kaf3/dimmer/altium projects/Smart Dimmer/Project Outputs for Smart Dimmer/print.PDF

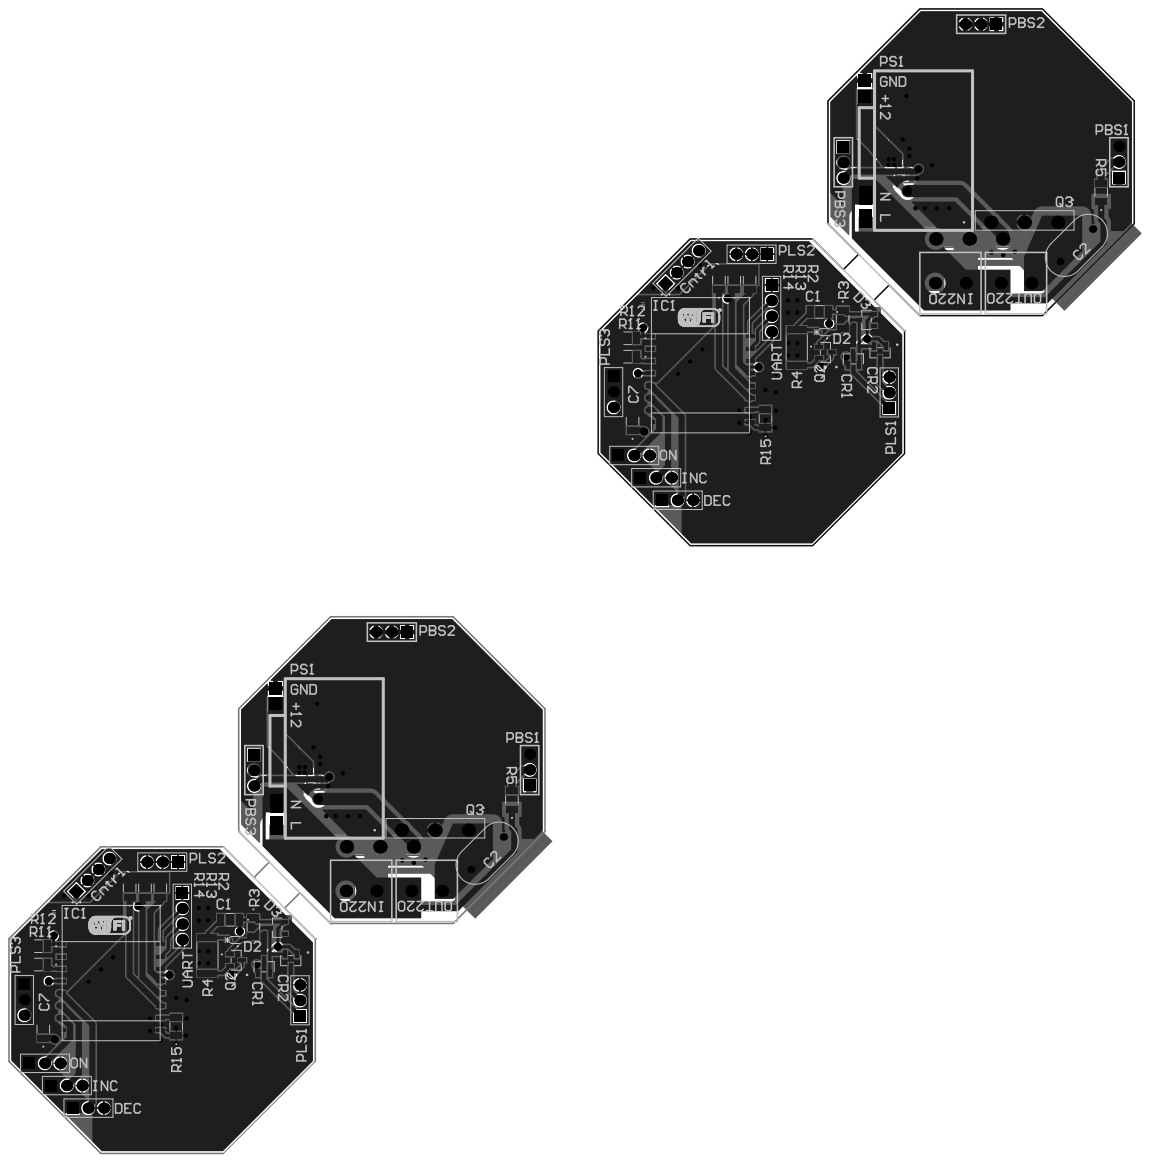
[picture p59: page 1]
