kaf3/dimmer/altium projects/Smart Dimmer/dimmer.pdf

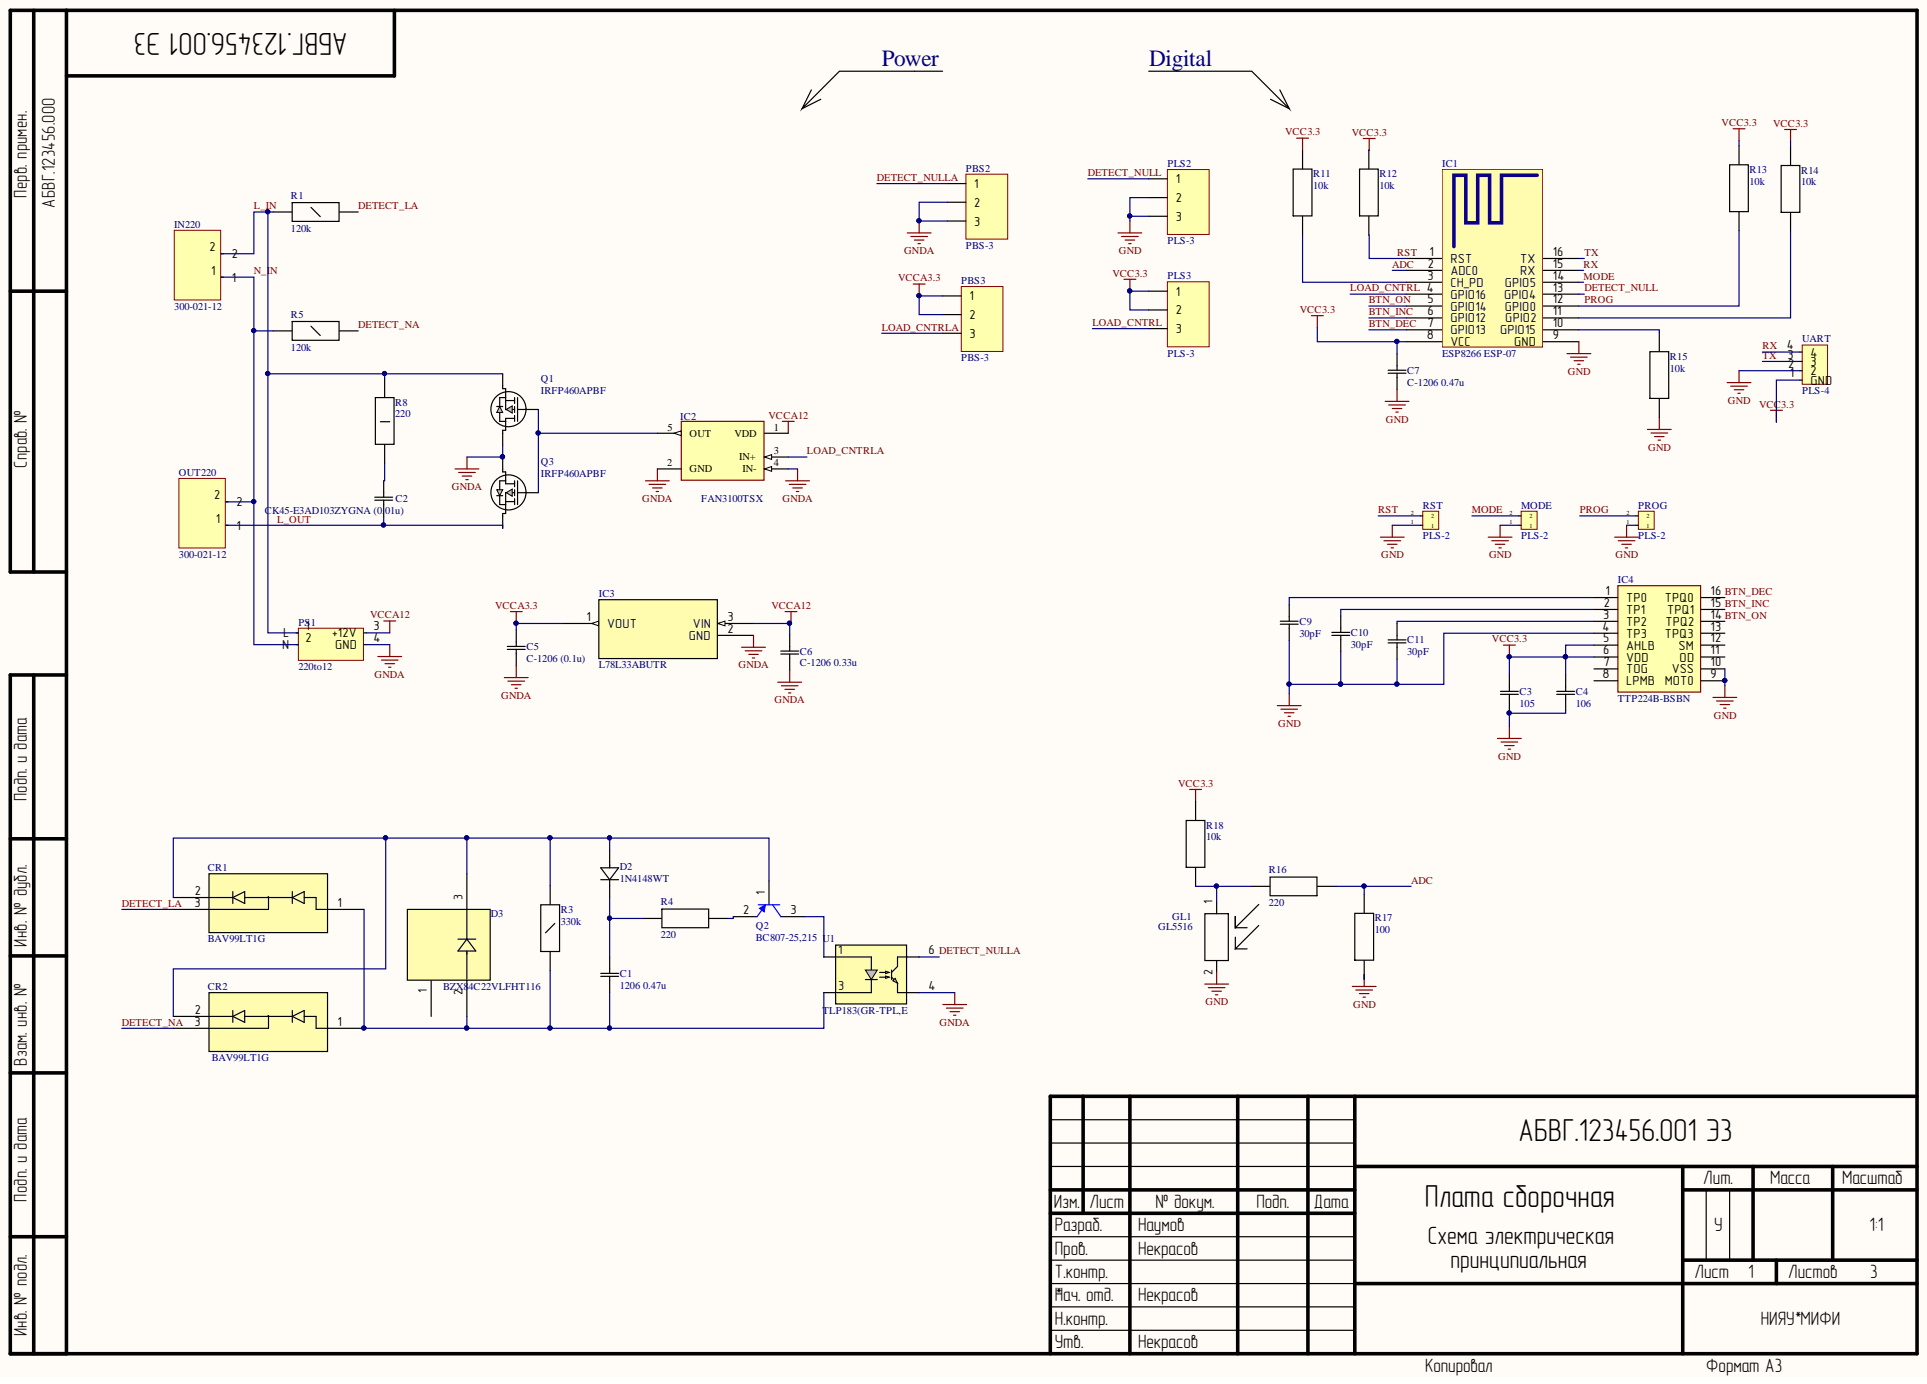
[picture p61: page 1]

Инв. № подл. Инв. № дубл. Подп. и дата Взам. инв. № Подп. и дата Перв. примен. Справ. №

АБВГ.123456.001 Э3

Плата сборочная принципиальная | Лит. | Масса | Масштаб

Изм. | Лист | № докум. | Подп. | Дата | | | У | | 1:1 Схема электрическая
Разраб. | | Наумов
Пров. | | Некрасов
Т.контр. | | | | | Лист 1 | Листов 3
* Нач. отд. | Некрасов | | | | НИЯУ МИФИ *
Н.контр.
Утв. | Некрасов
