kaf3/dimmer/altium projects/Smart Dimmer/drafts/PCB12_sensor.PDF

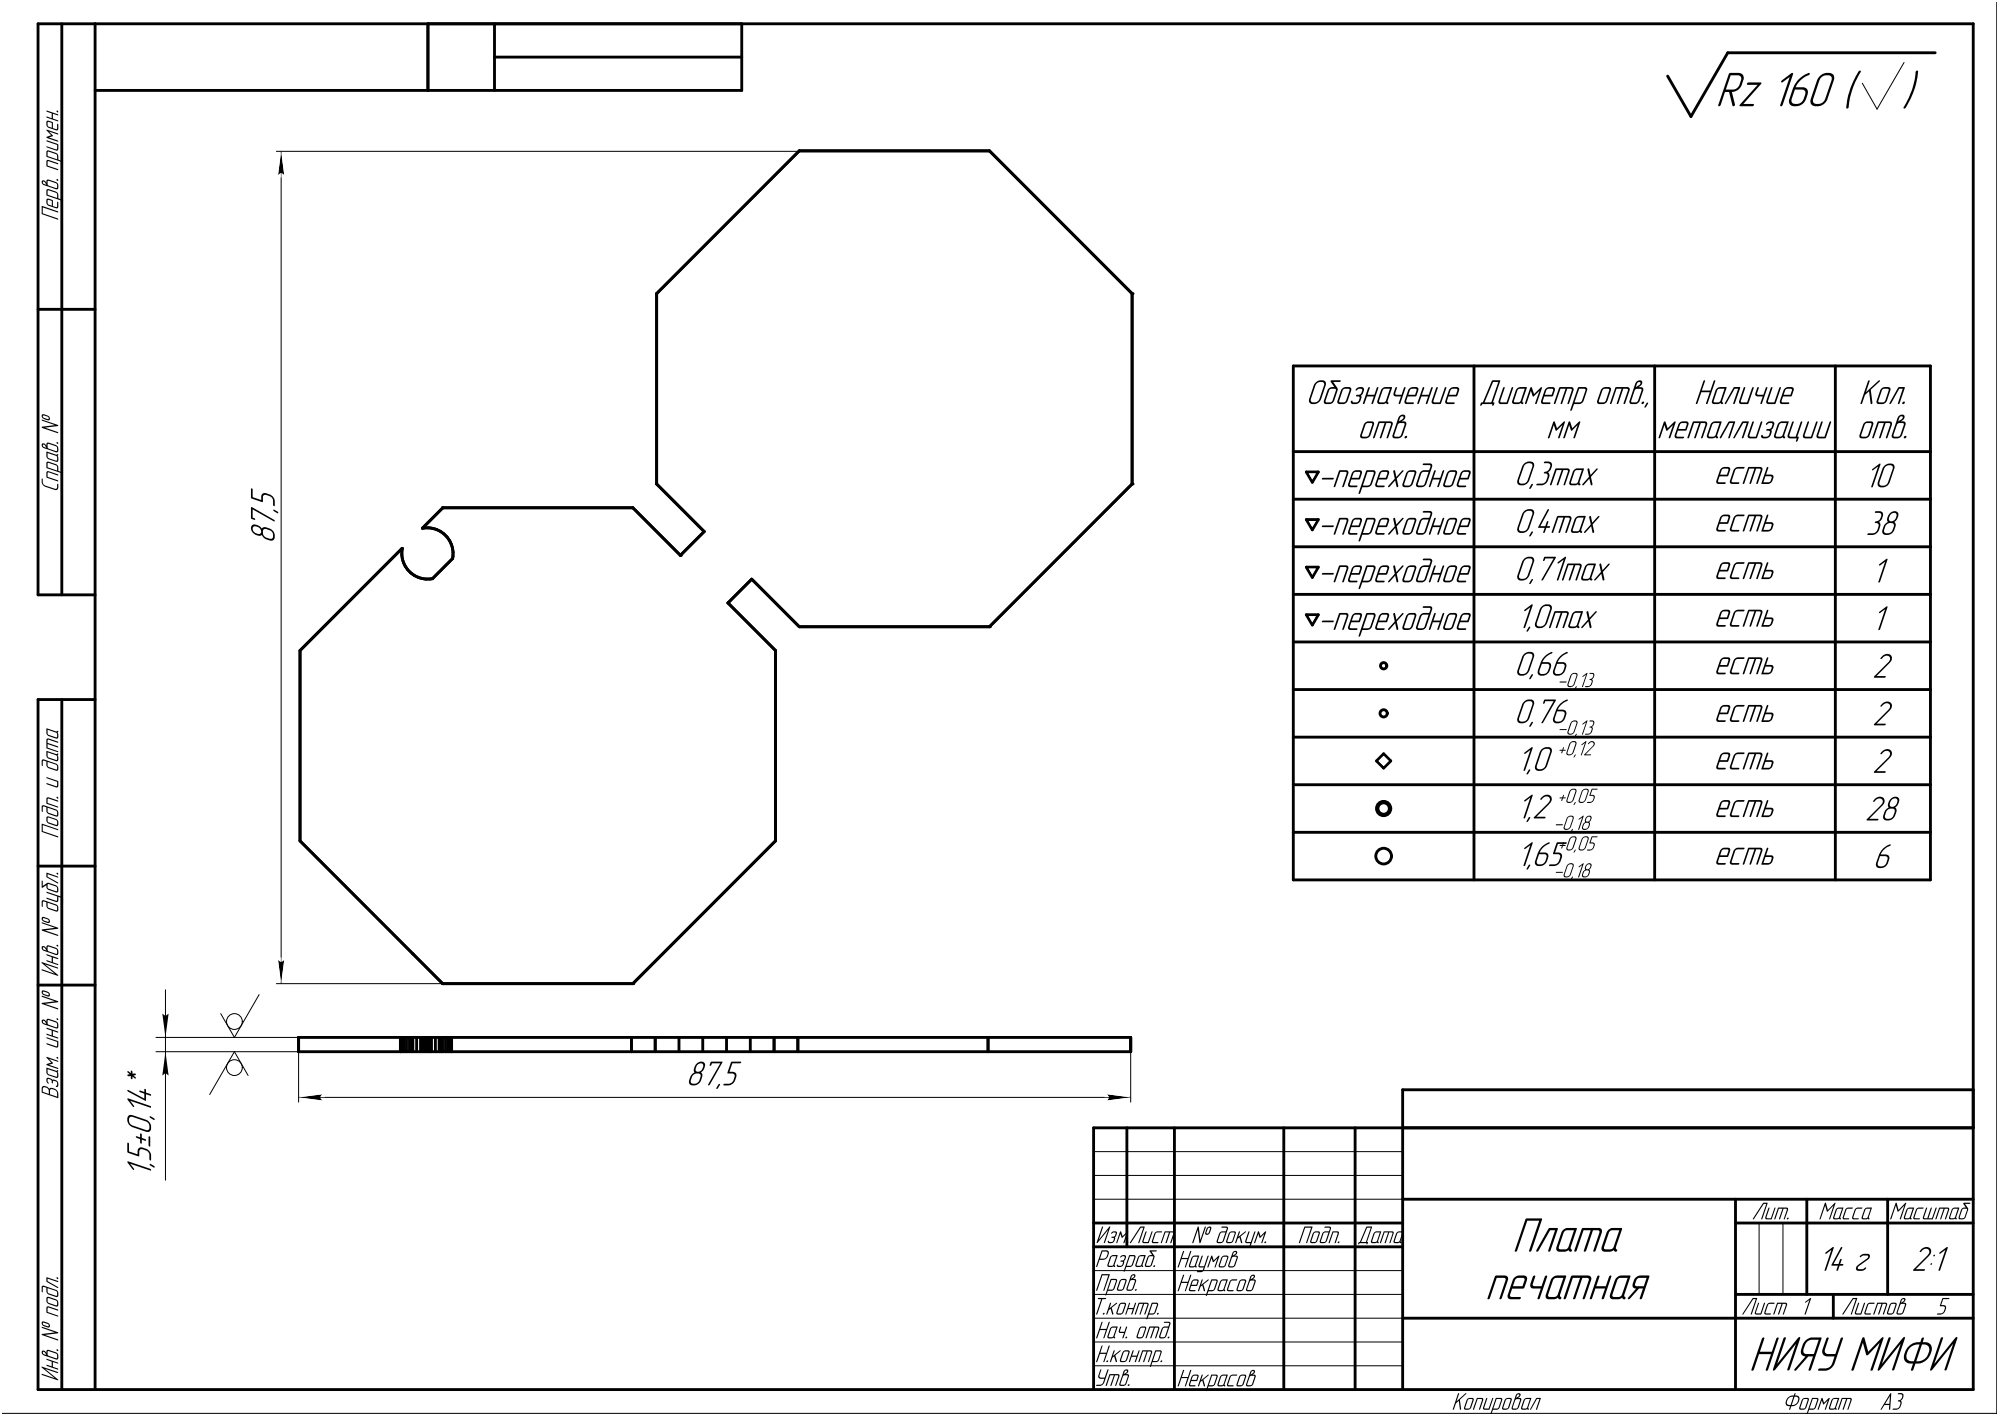
[picture p63: page 1]

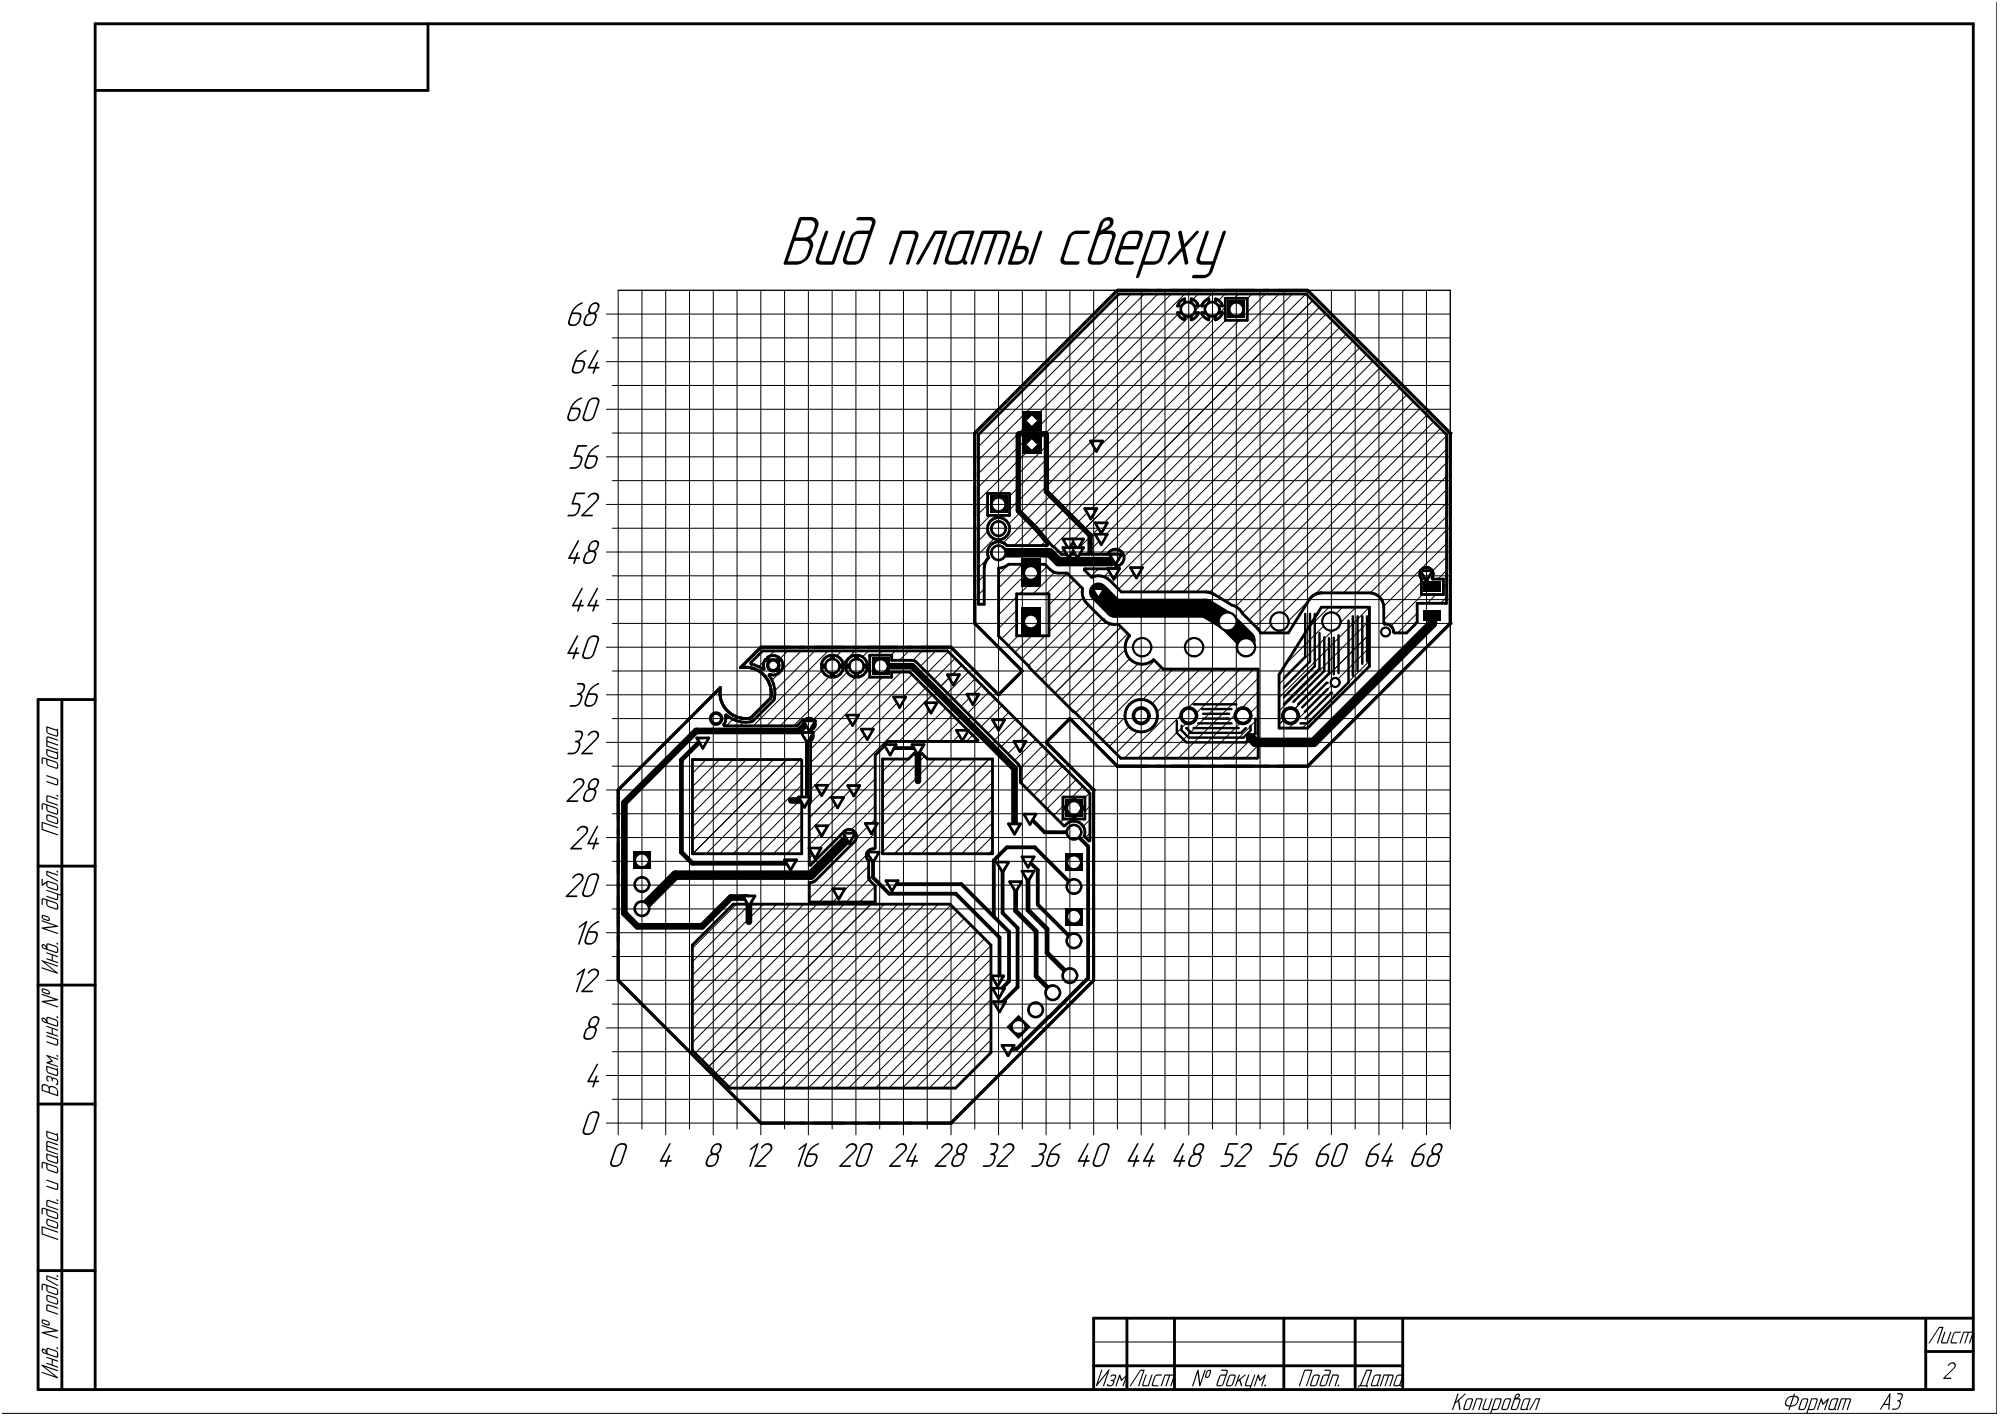
[picture p64: page 2]

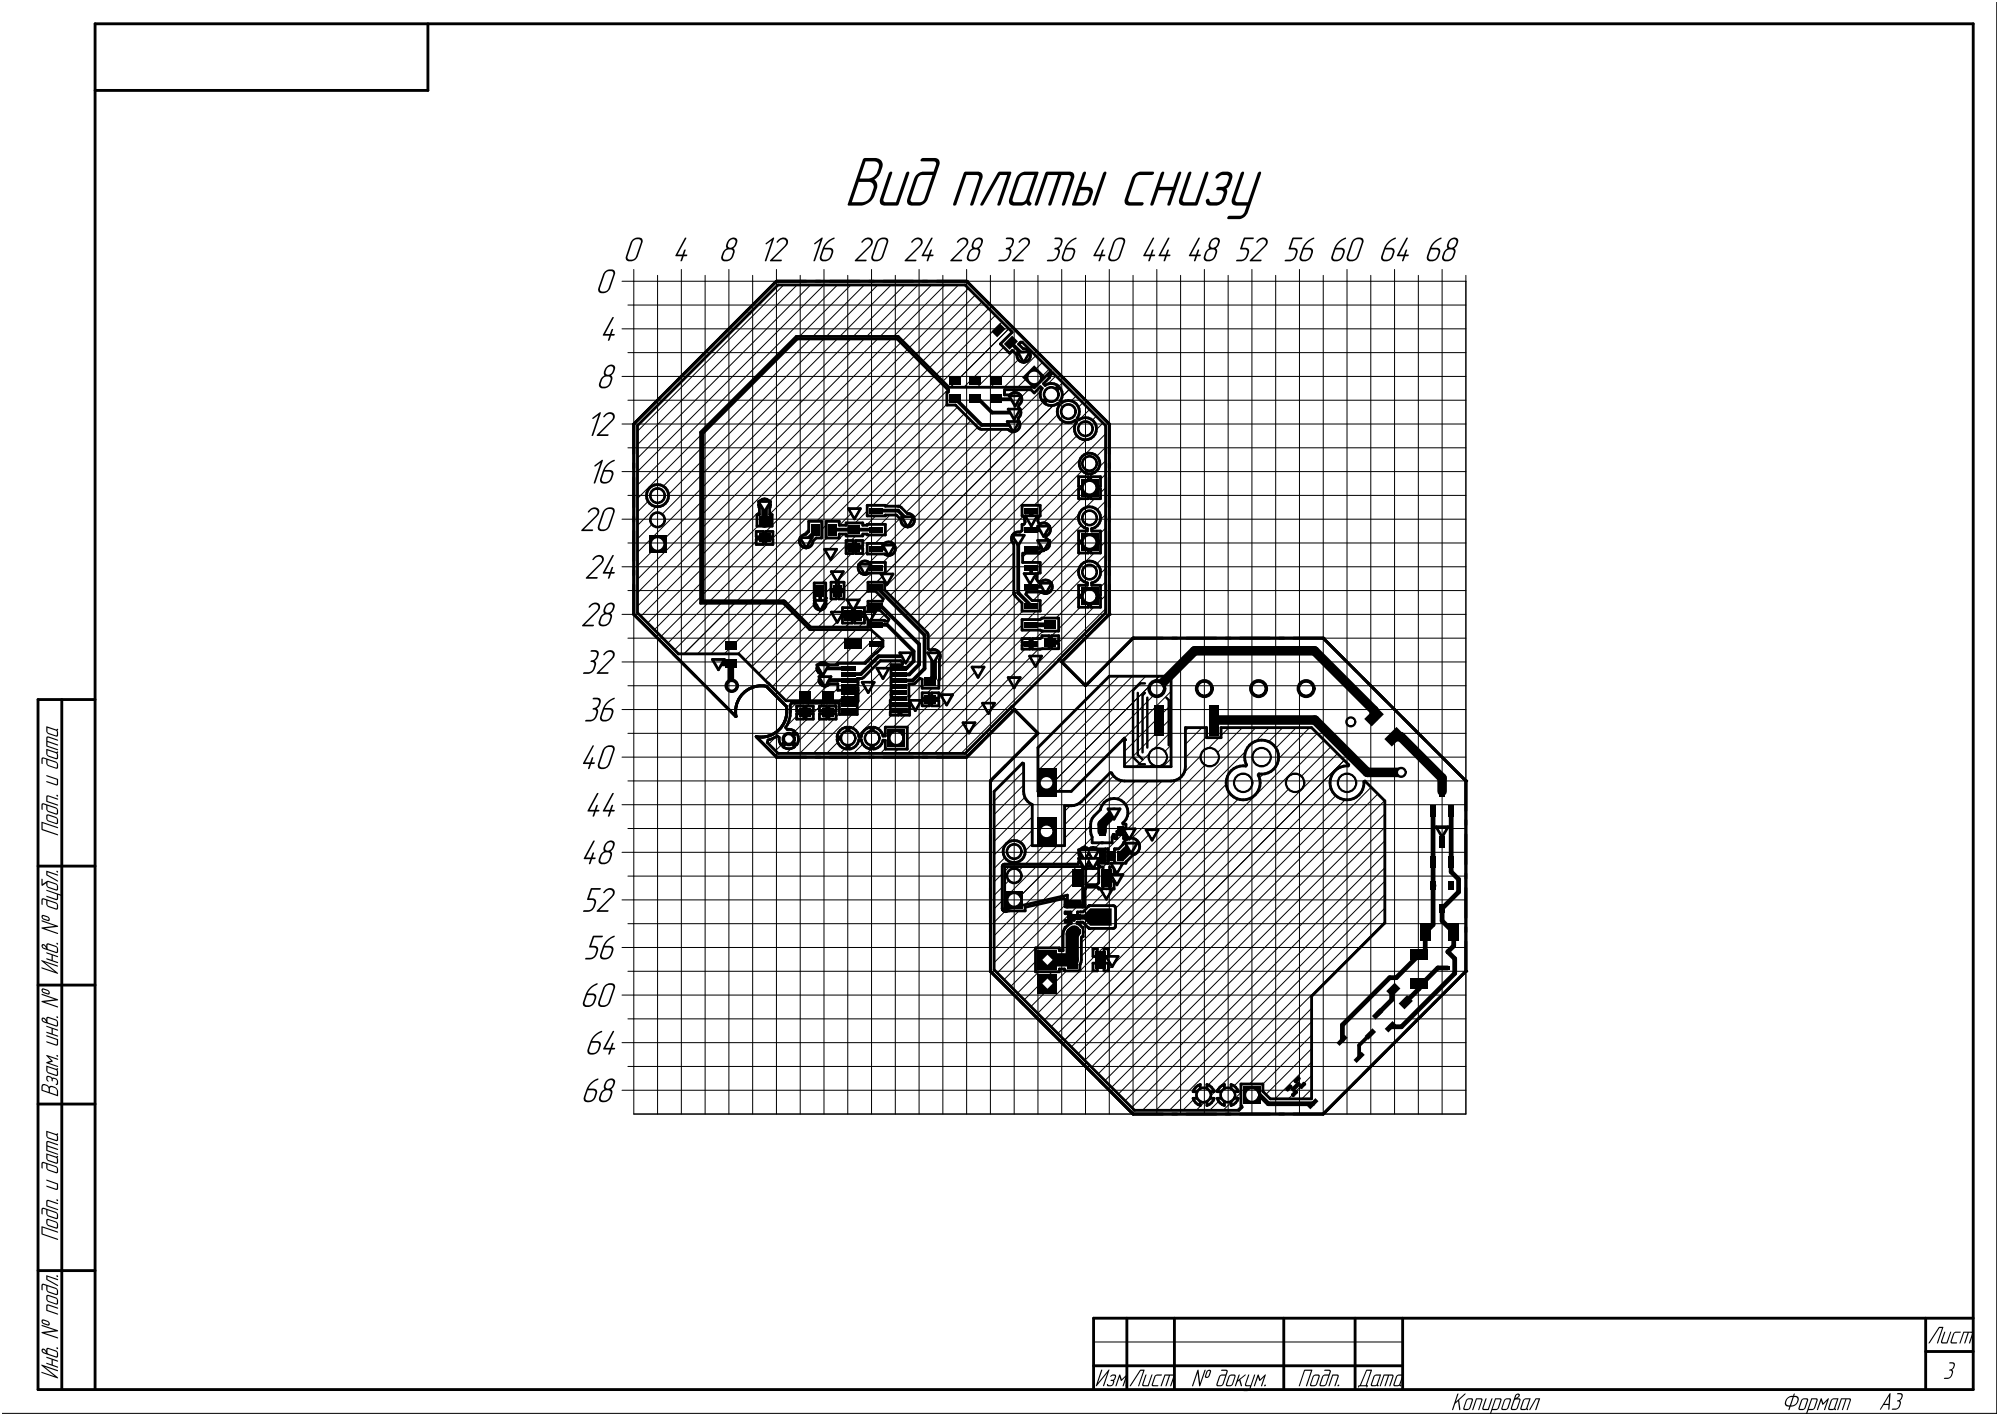
[picture p65: page 3]

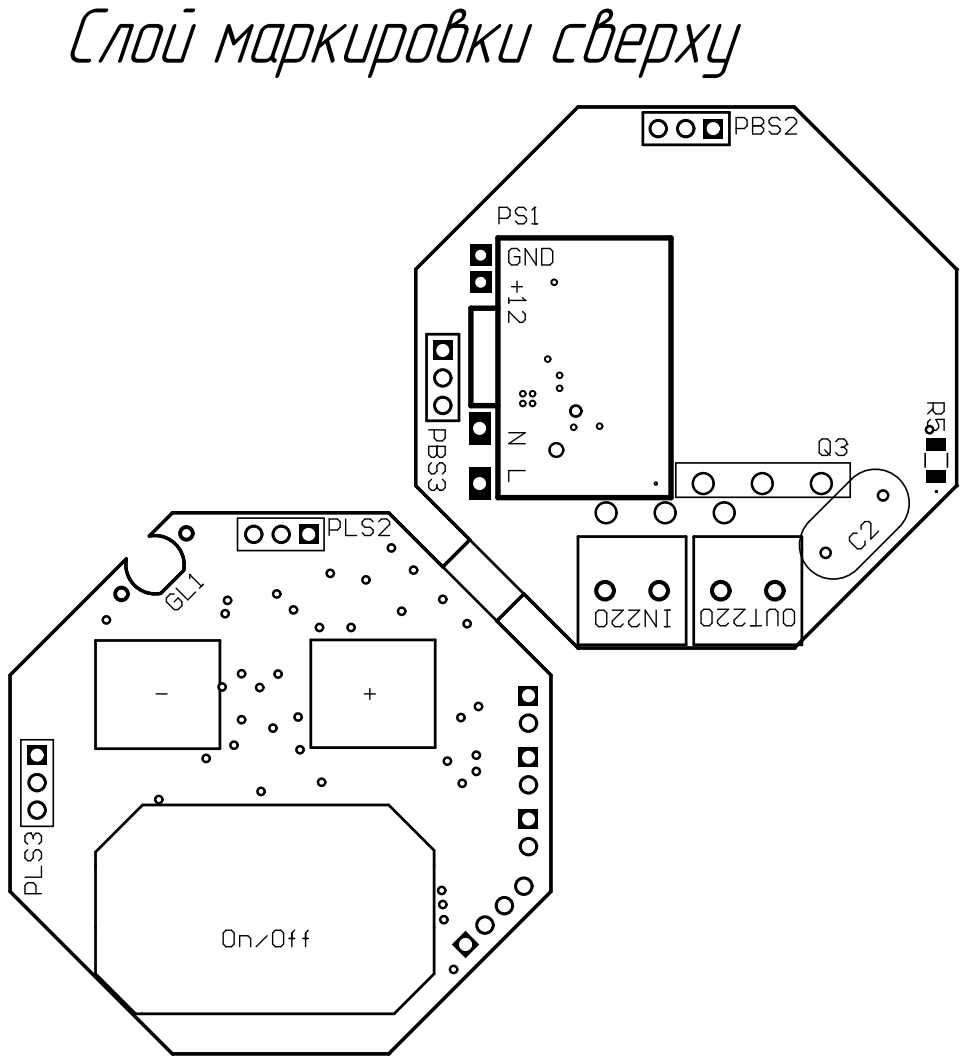
[picture p66: page 4]

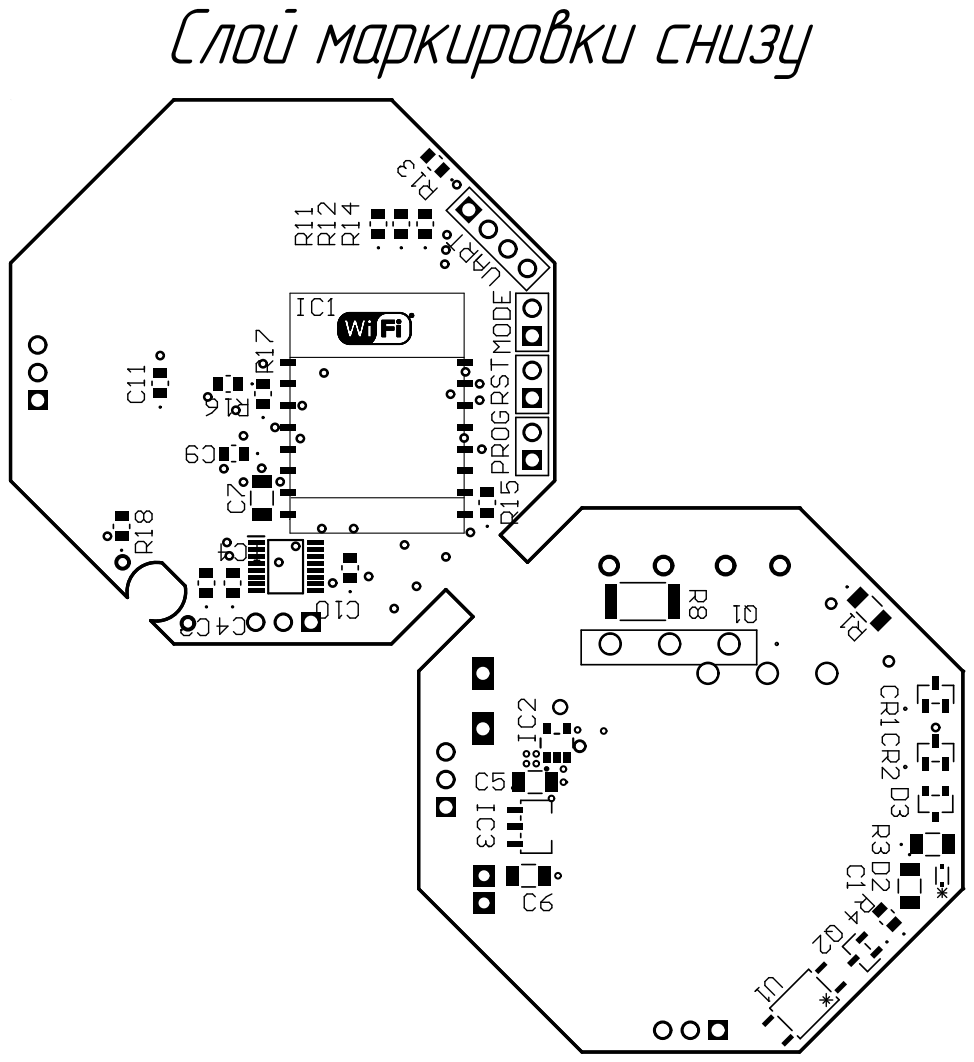
[picture p67: page 5]
