kaf3/dimmer/altium projects/Smart Dimmer/Project Outputs for Smart Dimmer/outDocs.PDF

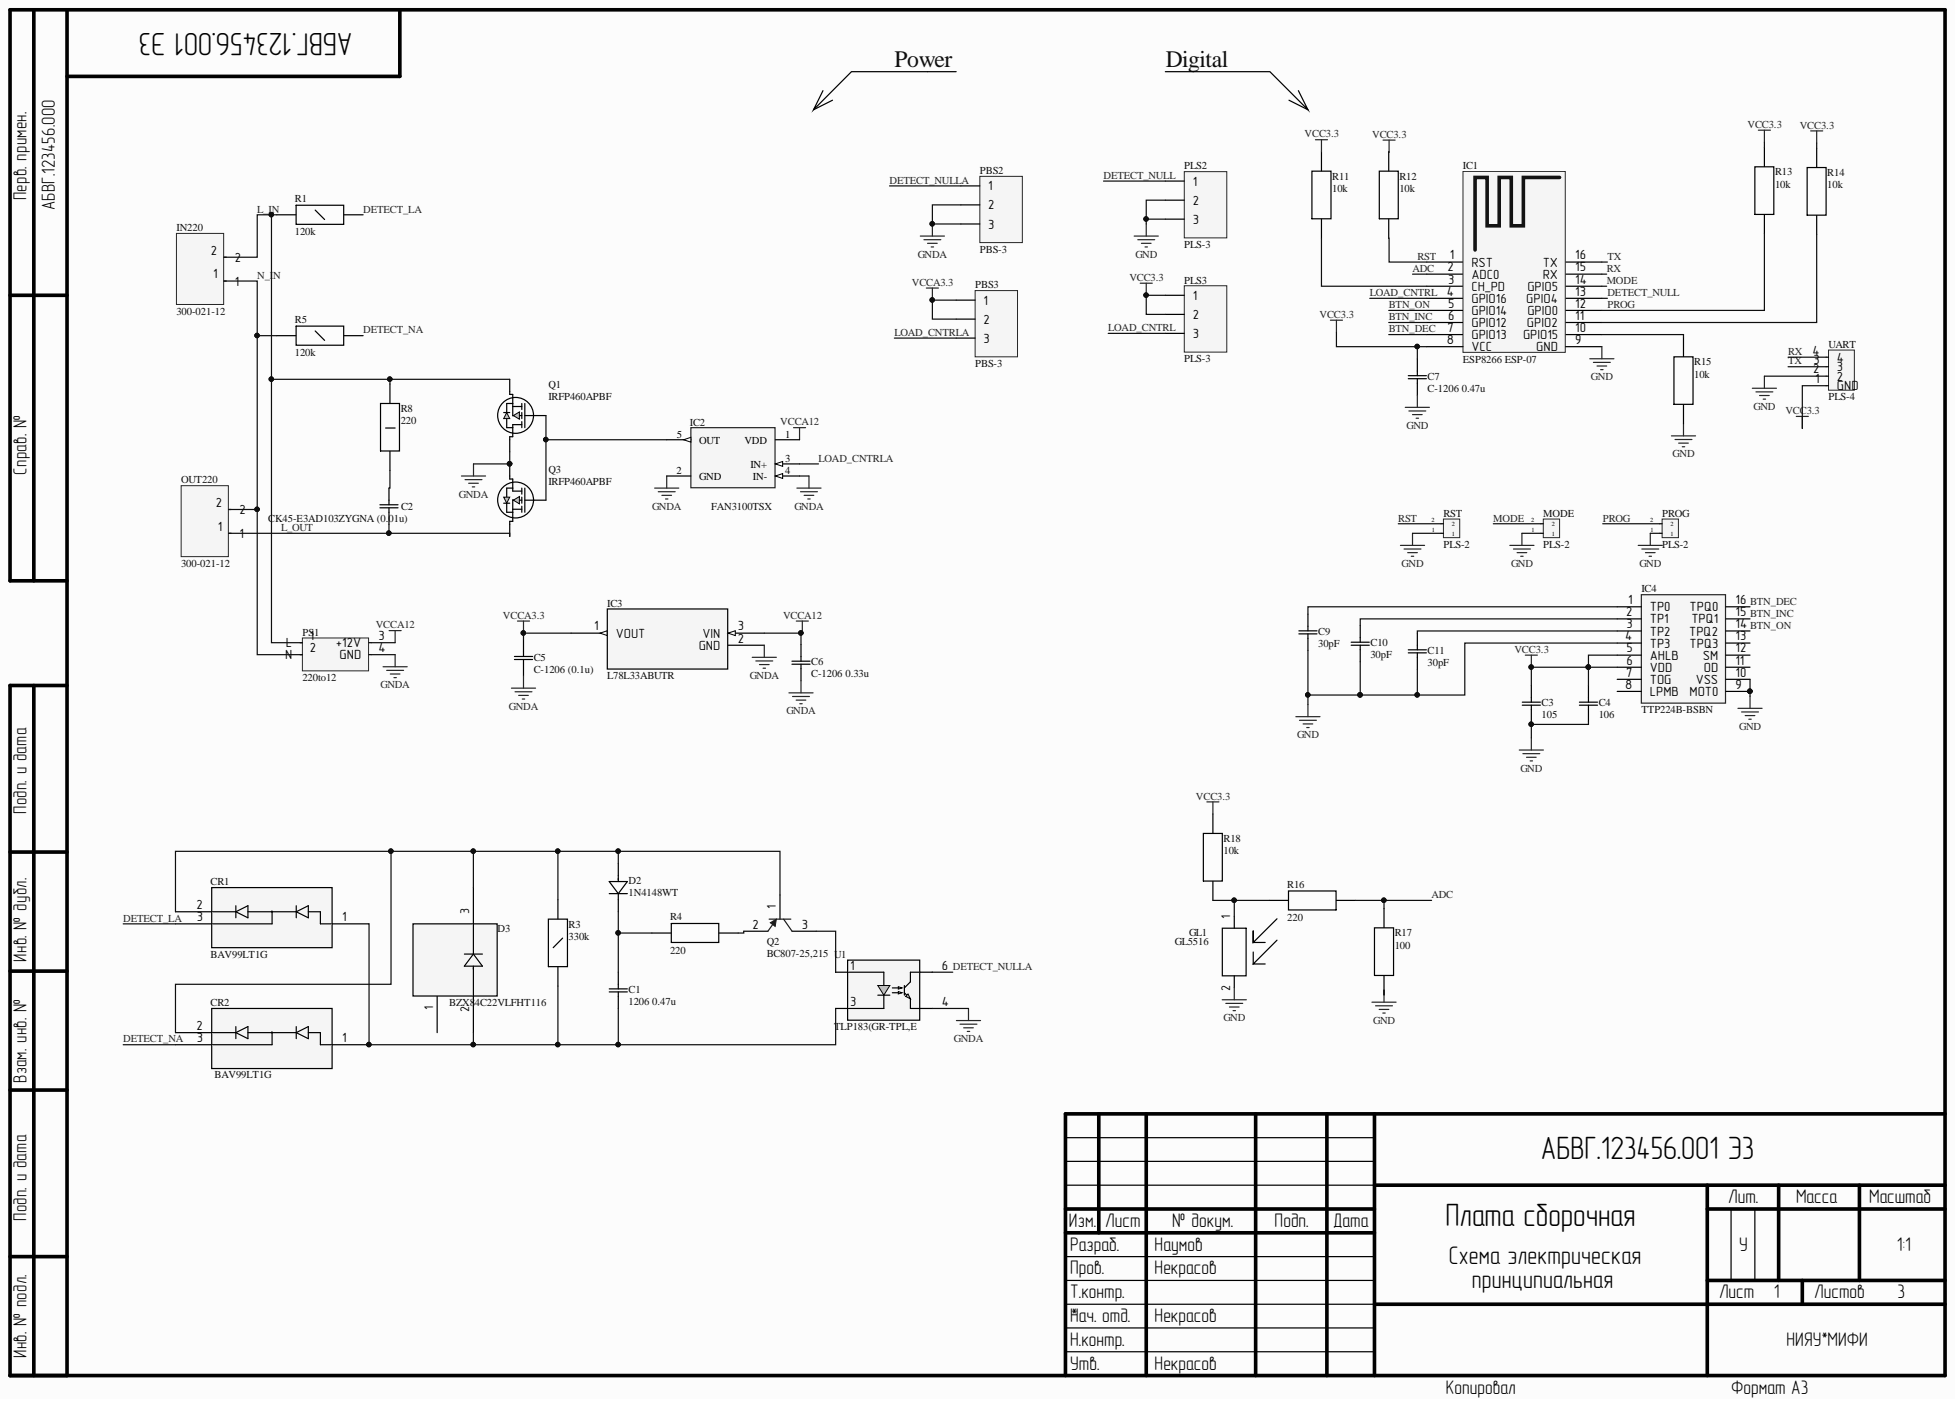
[picture p68: page 1]

Инв. № подл. Инв. № дубл. Подп. и дата Взам. инв. № Подп. и дата Перв. примен. Справ. №

АБВГ.123456.001 Э3

Плата сборочная принципиальная | Лит. | Масса | Масштаб

Изм. | Лист | № докум. | Подп. | Дата | | | У | | 1:1 Схема электрическая
Разраб. | | Наумов
Пров. | | Некрасов
Т.контр. | | | | | Лист | Листов 3
* Нач. отд. | Некрасов | | | | НИЯУ МИФИ
Н.контр.
Утв. | Некрасов

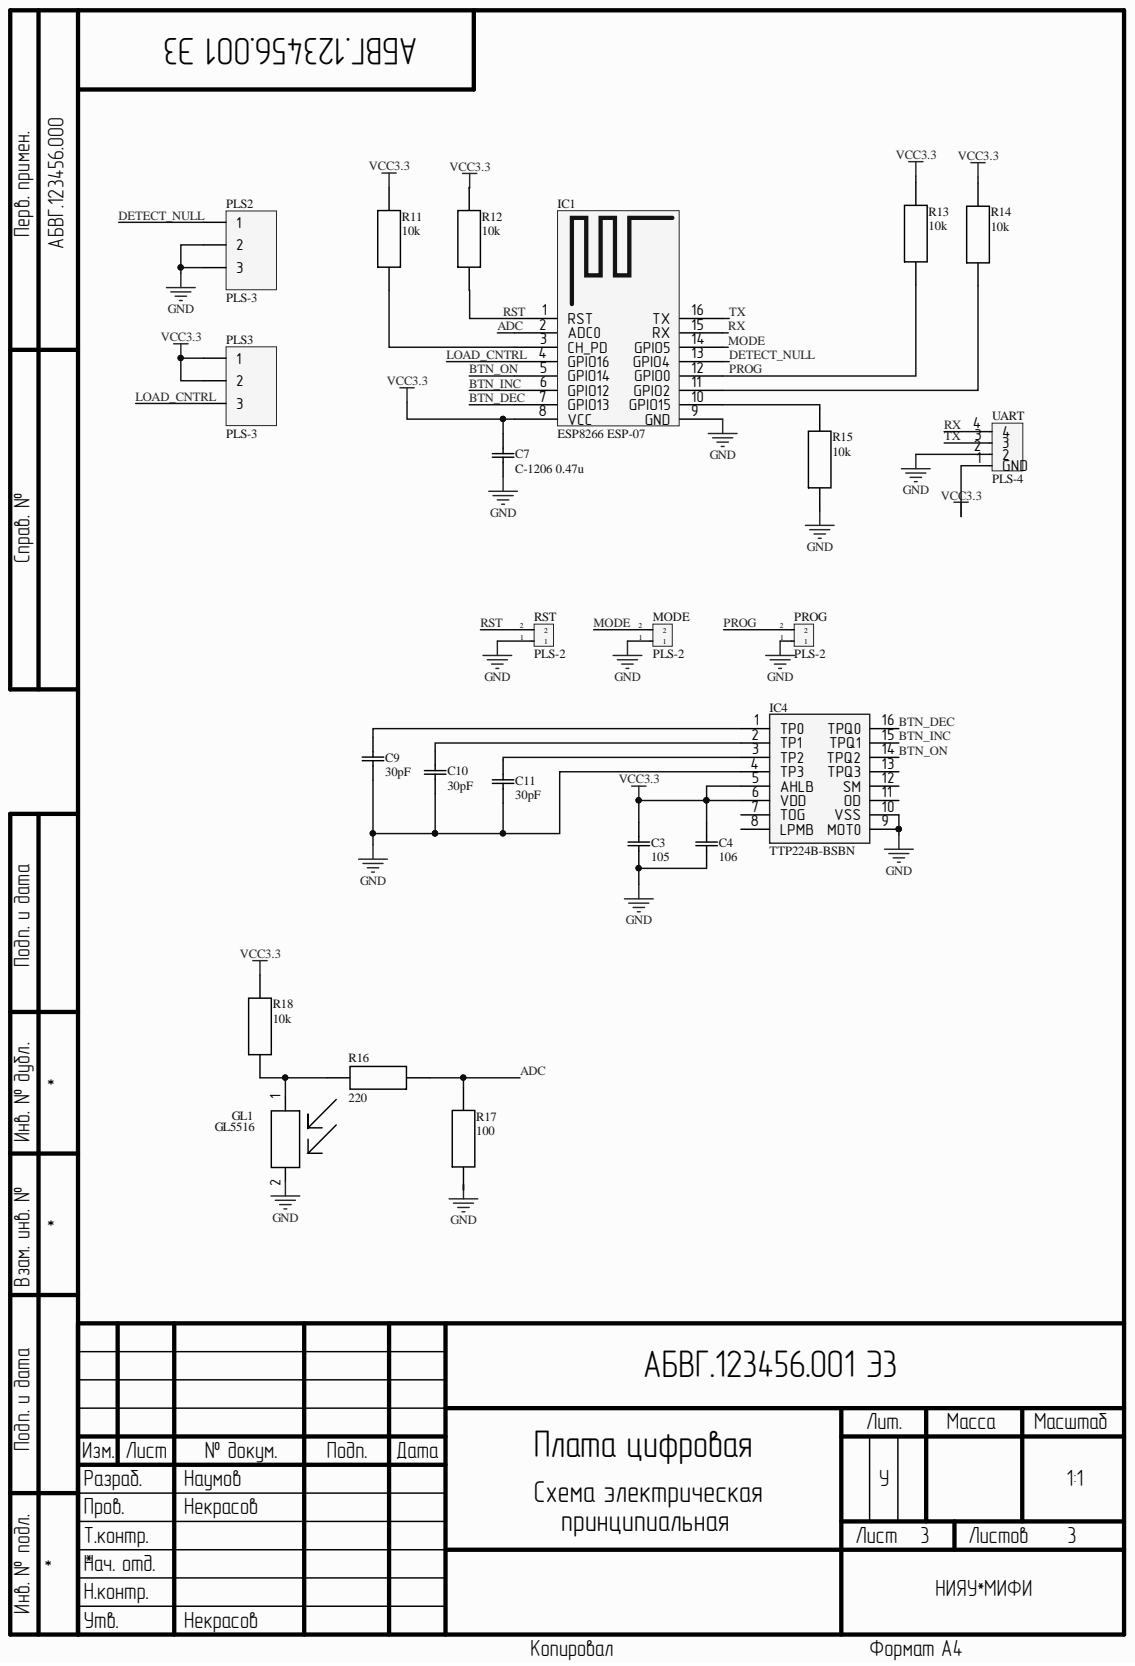
[picture p69: page 2]

Инв. № подл. Инв. № дубл. Подп. и дата Взам. инв. № Подп. и дата Перв. примен. Справ. №

АБВГ.123456.001 Э3

Плата цифровая принципиальная | Лит. | Масса | Масштаб

Изм. | Лист | № докум. | Подп. | Дата | | | У | | 1:1 Схема электрическая
Разраб. | | Наумов
Пров. | Некрасов

Лист | Листов 3

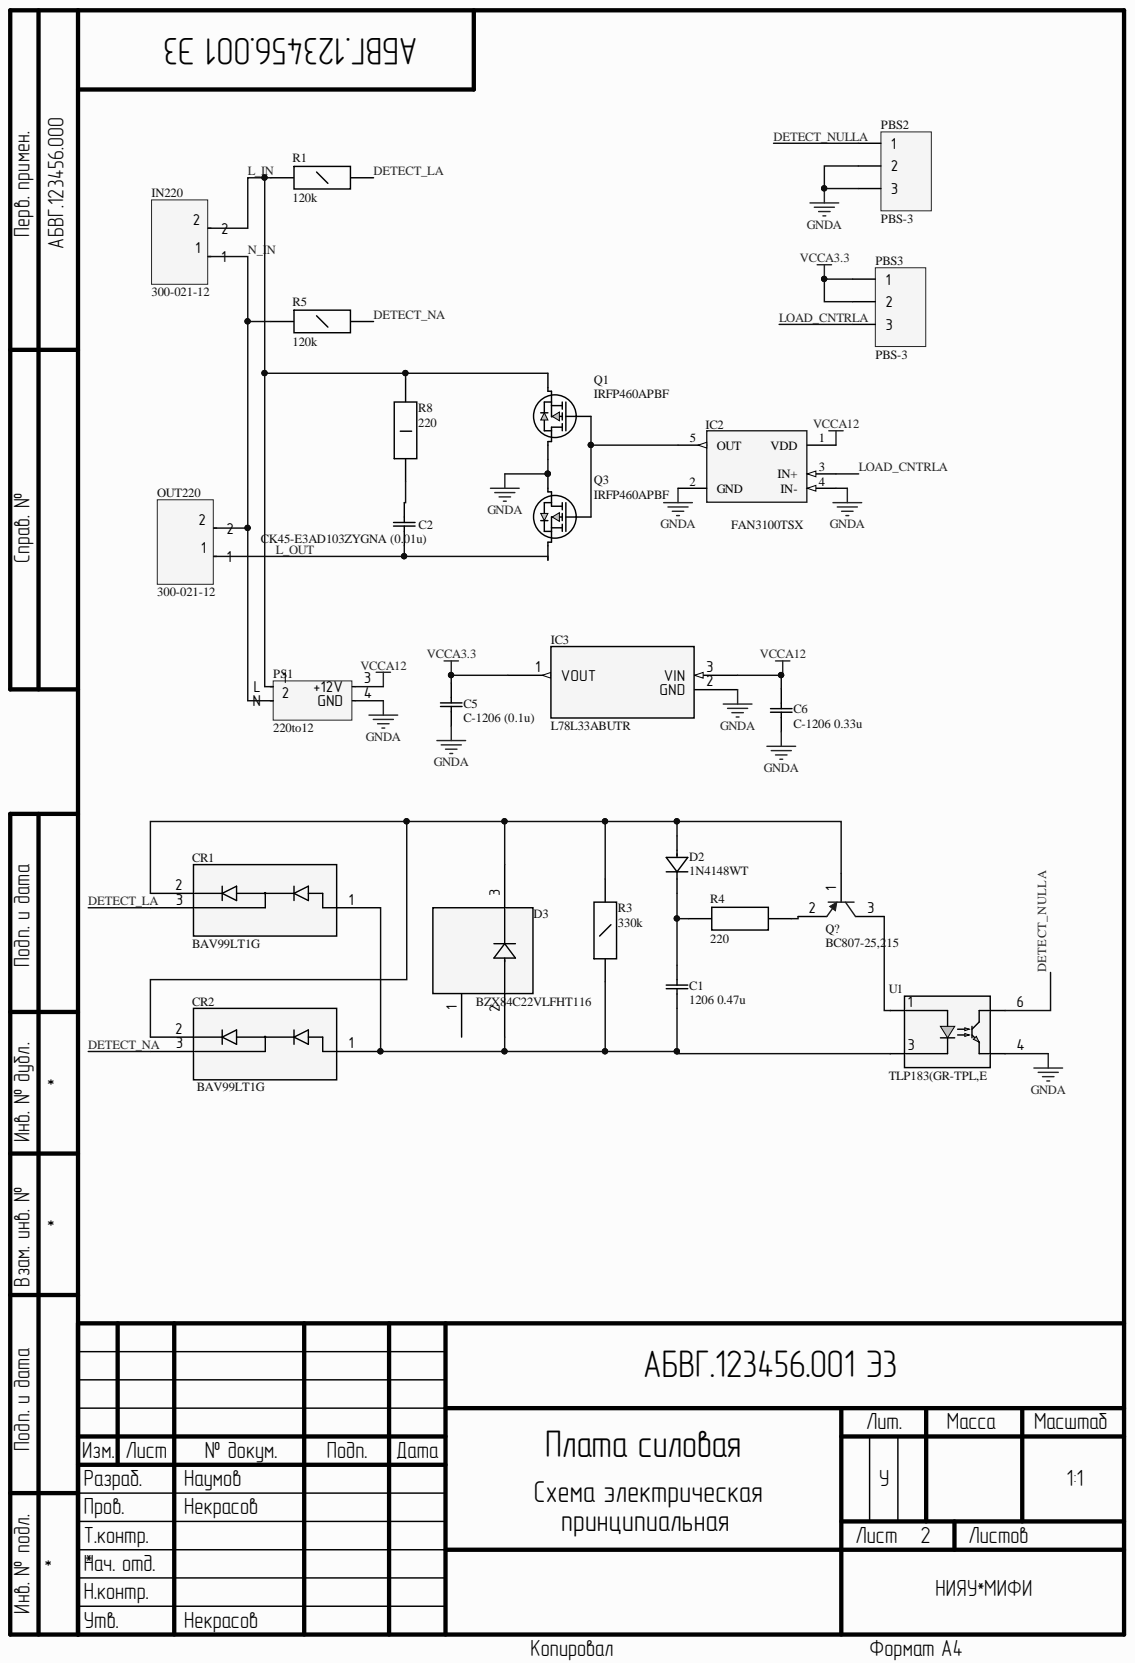
[picture p70: page 3]

Инв. № подл. Инв. № дубл. Подп. и дата Взам. инв. № Подп. и дата Перв. примен. Справ. №

АБВГ.123456.001 Э3

Плата силовая принципиальная | Лит. | Масса | Масштаб

Изм. | Лист | № докум. | Подп. | Дата | | | У | | 1:1 Схема электрическая
Разраб. | | Наумов
Пров. | Некрасов

Лист | Листов
