kaf3/dimmer/LTspice/examples/Educational/MeasureBW.asc

C1: cap; 1µ
C2: cap; 20µ
C3: cap; 100p
Q1: npn; 2N3904
R1: res; 10K
R2: res; 100K
R3: res; 1K
R4: res; 20K
V1: voltage; 9
V3: voltage; ""; AC 1
Named nets: 0, IN, OUT
.ac oct 10 1 10Meg
This example schematic is supplied for informational/educational purposes only.
.measure tmp max mag(V(out))
.measure BW trig mag(V(out))=tmp/sqrt(2) rise=1 targ mag(V(out))=tmp/sqrt(2) fall=last
Example of using a .measure script to measure the 3dB bandwidth of a response.
Execute View=>SPICE Error Log after running the simulation to see the output of the
.measure statements.
