kaf3/dimmer/LTspice/examples/Educational/SOAtherm-Tutorial.asc

C1: cap; .1µ
C2: cap; 68n
C3: cap; 220µ
C4: cap; 10n
C5: cap; 0.1µ
Q1: nmos; PSMN4R8100BSE
R1: res; 5.7m
R2: res; 49.9K
R3: res; 1.74K
R4: res; 2.67K
R5: res; 43.5K
R6: res; 3.57K
R7: res; 24K
R8: res; {Rload}
R9: res; 10
R10: res; 100K
U1: LTC4260; uvautoretry=1 ovautoretry=1 ocautoretry=1
V1: voltage; PWL(0 3.1 1 3.1 1.0001 0 1.2 0 1.20001 0)
V2: voltage; PWL(0 0 1u 3.1 1 3.1 1.0001 3.1)
V3: voltage; PWL(0 0 10u 0 100u 60 1.8 60 +0.1m 60)
Named nets: 0, OUT
.tran 2.5
.options SOAaccounting=1 ; turns on SOA accouting for MOSFETs that include thermal data
simulate board detection
.param Rload=10
.step param Rload list 1 10 50 100
