kaf3/dimmer/LTspice/examples/Educational/stepAC.asc

C1: cap; 420p
C2: cap; 420p
C3: cap; {C}
I1: CURRENT; 0; AC 5m
L1: ind; 1µ
L2: ind; 1µ
R1: RES; 300
R2: res; 300
Named nets: 0, IN, OUT
.ac oct 200 5Meg 10Meg
.step param C 50p 150p 50p
This example schematic is supplied for informational/educational purposes only.
This example demonstrates .stepping a global parameter,
C, while computing the transfer function of the filter.
