kaf3/dimmer/LTspice/examples/jigs/2ndOrderAllpass.asc

G1: g; {2/R1}
G2: g; {1/R1}
G3: g2; {1/R1}
G4: g; {10*H}
L2: ind; {L1}; Rpar={R1}; Cpar={C1}
R1: res; {R1}
R2: res; .1
X1: jumper
X2: jumper
Named nets: 0, 1, 2
.param f0=1k Q=.7
Most efficient LTSPICE implementation for f0 and Q set by parameters >>>
.param R1=1k
.param C1=Q/(2*pi*f0*R1)
.param L1= 1/(C1*(2*pi*f0)**2)
Vin
Vout
