kaf3/dimmer/LTspice/examples/jigs/2ndOrderBandpass.asc

G1: g; {2/R1}
G2: g; {10*H}
L1: ind; {L1}; Cpar={C1}
R1: res; {R1/2}
R2: res; {R1/2}
R3: res; .1
X1: jumper
X2: jumper
Named nets: 0, 2, 1
.param f0= 1k Q=.5
.param R1=1k
.param L1=1/(C1*(2*pi*f0)**2)
Most efficient LTSPICE implementation for f0 and Q set by parameters >>>
R1 is arbitary >>>
This version puts 1/2 the R1 resistance in the capacitor
.param C1=Q/(R1*2*pi*f0)
Vout
Vin
