kaf3/dimmer/LTspice/examples/jigs/2ndOrderComplexzero.asc

C2: cap; {C1}
G1: g; {2*f0**2/(R1*fn**2)}
G2: g; {2m*K1}
G3: g; {1m}
G4: g; {1m*K2}
G5: g; {10*H}
L1: ind; {L1}
R1: res; {R1/2}
R2: res; {R1/2}
R3: res; .1
R4: res; 1k
X1: jumper
X2: jumper
Named nets: 0, 1, 2
.param f0=1e3 Q=2.5 fn=2e3 Qn=1
2nd Order Complex Zero LTSPICE implementation for f0,  Q,  fn, and Qn set by parameters >>>
.param R1=1k
.param K1 = (fn*Q)/(f0*Qn)
.param K2 = (fn/f0)**2
.param L1 = R1*Q/(2*pi*f0)
.param C1 = 1/(L1*(2*pi*f0)**2)
Vin
Vout
