kaf3/dimmer/LTspice/examples/jigs/2ndOrderLowpass.asc

C2: cap; {C1}
G1: g; {2/R1}
G4: g; {10*H}
L1: ind; {L1}; Rser={R1/2}
R2: res; {R1/2}
R4: res; .1
X1: jumper
X2: jumper
Named nets: 0, 1, 2
.param f0=1e3 Q=.5
2nd Order Low Pass LTSPICE implementation for f0,  Q,  fn, and Qn set by parameters >>>
.param R1=1k
.param L1 = R1*Q/(2*pi*f0)
.param C1 = 1/(L1*(2*pi*f0)**2)
Vin
Vout
