kaf3/dimmer/LTspice/examples/jigs/2ndOrderNotch.asc

C1: cap; {C1}; Lser={L1}
G1: g; {4/R1}
G2: g; {10*H}
R1: res; {R1/2}
R2: res; {R1/2}
R3: res; {R1}
R4: res; .1
X1: jumper
X2: jumper
Named nets: 0, 2, 1
.param f0= 1k Q=.5
.param R1=1k
.param L1=R1*Q/(4*pi*f0)
Most efficient LTSPICE implementation for f0 and Q set by parameters >>>
R1 is arbitary >>>
This version puts 1/2 the R1 resistance in the capacitor
.param C1=1/(L1*(2*pi*f0)**2)
Vout
Vin
