kaf3/dimmer/LTspice/Draft1.asc

C1: cap; 0.47µ; V=50 Irms=0 Rser=0 Lser=0 mfg="Murata" pn="GCM21BR71H474KA55" type="X7R"
C2: cap; 10n; V=500 Irms=867m Rser=0.0254657 Lser=0
C3: polcap; 2.2µ; V=400
C4: cap; 100n
C5: polcap; 0.1µ; V=400
C6: polcap; 0.33µ; V=400
D1: diode
D2: schottky; DI_1N4148WT
D3: zener; BZX84C22VL
D5: zener; BZX84C11VL
Q2: pnp; BC807-25
R1: res; 121K; tol=1 pwr=0.1
R2: res; 10k; tol=1 pwr=0.1
R3: res; 330k
R4: res; 221; tol=1 pwr=0.1
R5: res; 121K; tol=1 pwr=0.1
R6: res; 400
R7: res; 121k
R8: res; 221; tol=1 pwr=1
R9: res; 121k
R10: res; 220
R11: res; 400
U1: TLP183
U3: LTC4446
U4: BAV99
U5: BAV99
U6: BAV99
U7: ADP7118-3.3
U8: BAV99
U9: irfp460
U10: irfp460
V1: voltage; 12
V2: voltage; SINE(0 220 50)
V3: voltage; PULSE(0 3.3 0 0.00001 0 0.005 0.01)
V4: voltage; SINE(0 220 50)
V5: voltage; SINE(0 220 50)
Named nets: 0, VCC12, VCC3.3, L_IN, N_IN, L_OUT, GATE, DETECT_NULL
.inc DIODE_BAV99.mod
.tran 0 5.05 5 uic
.MODEL DI_1N4148WT D( IS=10.4n RS=51.5m BV=80.0 IBV=1.00u
+ CJO=2.00p  M=0.333 N=2.07 TT=5.76n )
.inc TK20J50D.mod
Q1
Q3
