kaf3/dimmer/LTspice/examples/Educational/100W.asc

C1: cap; 100n
C2: cap; 18p
C3: cap; 18p
C4: cap; 47µ
C5: cap; 100µ
C6: cap; 330p
C7: cap; 2.2µ
C8: cap; 3p
Q1: nmos; IRFP240
Q2: pmos; IRFP9240
Q3: pnp; MJE350
Q4: pnp; MJE350
Q5: npn; MJE340
Q6: npn; MJE340
Q7: pnp; MJE350
Q8: pnp; MJE350
Q9: pnp; MJE350
Q10: pnp; MJE350
R1: res; .33
R2: res; .33
R3: res; 10
R4: res; 470
R5: res; 470
R6: res; 100
R7: res; 890
R8: res; 100
R9: res; 100
R10: res; 10K
R13: res; 3.9K
R14: res; 3.9K
R15: res; 470
R16: res; 1K
R17: res; 10K
R18: res; 10K
R19: res; 27K
R20: res; 1K
R21: res; 2.2K
R22: res; 47K
R23: res; 8
R24: res; 3.67Meg
R25: res; 6.1Meg
V1: voltage; 50
V2: voltage; 50
V3: voltage; ac 1
Vin: voltage; SINE(0 {V} 1K)
Named nets: 0, OUT, +V, -V, OUT1
.tran 10m
;.ac oct 50 1M 10Meg ; plot V(out)/V(out1) to see 72° phase margin @ 950kHz
;.dc temp -55 125 1
;.noise V(out) Vin oct 10 10 20K
.options plotwinsize=0 numdgt=15 noopiter
.four 1K V(out)
.model MJE340 NPN(Is=1.03431e-13 BF=172.974 NF=.939811 VAF=27.3487 IKF=0.0260146 ISE=4.48447e-11 Ne=1.61605 Br=16.6725
+ Nr=0.796984 VAR=6.11596 IKR=0.10004 Isc=9.99914e-14 Nc=1.99995 RB=1.47761 IRB=0.2 RBM=1.47761 Re=0.0001 RC=1.42228
+ XTB=2.70726 XTI=1 Eg=1.206 CJE=1e-11 VJE=0.75 Mje=.33 TF=1e-09 XTF=1 VTF=10 ITF=0.01 CJC=1e-11 VJC=.75 MJC=0.33 XCJC=.9
+ Fc=0.5 CJS=0 VJS=0.75 MJS=0.5 TR=1e-07 PTF=0 KF=0 AF=1)
.model MJE350 PNP(Is=6.01619e-15 BF=157.387 NF=.910131 VAF=23.273 IKF=0.0564808 Ise=4.48479e-12 Ne=1.58557 BR=0.1
+ NR=1.03823 VAR=4.14543 IKR=.0999978 ISC=1.00199e-13 Nc=1.98851 RB=.1 IRB=0.202965 RBM=0.1 Re=.0710678 Rc=.355339
+ XTB=1.03638 XTI=3.8424 Eg=1.206 Cje=1e-11 Vje=0.75 Mje=0.33 TF=1e-09 XTF=1 VTF=10 ITF=0.01 Cjc=1e-11 Vjc=0.75
+ Mjc=0.33 XCJC=0.9 Fc=0.5 Cjs=0 Vjs=0.75 Mjs=0.5 TR=1e-07 PTF=0 KF=0 AF=1)
.param V=1.44 ; 100W RMS
.step oct param V 1m 1.44 2
100W into 8O at less than  .1% THD
Adjust R7 for 15mA quiescent current through Q1/Q2
R24 & R24 are optional output offset trimming
