kaf3/dimmer/LTspice/examples/Educational/1563.asc

R1: RES; 10K
R2: res; 100K
R3: res; 100K
U1: TOWTOM2
V1: VOLTAGE; AC 1
Named nets: IN, 0
.include TowTom2.sub
.ac oct 100 1k 10Meg
This example schematic is supplied for informational/educational purposes only.
