kaf3/dimmer/LTspice/examples/Educational/160.asc

A1: AND
A2: AND
A3: AND
A4: AND; TD=10N
A5: DFLOP
A6: INV
A7: INV
A8: INV
A9: INV
A10: AND
A11: AND
A12: AND
A13: AND; TD=10N
A14: DFLOP
A15: INV
A16: INV
A17: AND
A18: AND
A19: AND
A20: AND; TD=10N
A21: DFLOP
A22: INV
A23: INV
A24: AND
A25: AND
A26: AND
A27: AND; TD=10N
A28: DFLOP
A29: AND
A30: AND
A31: AND
A32: AND
A33: AND
A34: AND
A35: AND
A36: AND
A37: INV
A38: AND
A39: INV
A41: AND
A42: INV
I1: CURRENT; PWL(0 1 1.5M 1 1.51M 0 2.5M 0 2.51M 1 3.5M 1)
I2: CURRENT; PWL(0 1 4.5M 1 4.51M 0 5.5M 0 5.51M 1 6.5M 1)
I3: CURRENT; 1.
I5: CURRENT; 1.
I6: CURRENT; PULSE(0 1 0 0 0 .5M 1M)
J1: JUMPER
J2: JUMPER
J3: JUMPER
J4: JUMPER
J5: JUMPER
J6: JUMPER
R1: RES; 1.
R2: RES; 1.
R3: RES; 1.
R4: RES; 1.
R5: RES; 1.
Named nets: QA, QB, QC, QD, RC, 0, _CLR, A, B, C, _LD, ENP, D, CLK, ENT
74160 decade counter
.tran 1u 100m
This example schematic is supplied for informational/educational purposes only.
