kaf3/dimmer/LTspice/examples/Educational/astable.asc

C1: cap; .01µ
C2: cap; .01µ
Q1: NPN; 2N3904
Q2: npn; 2N3904
R1: RES; 2K
R2: res; 2K
R3: res; 101K
R4: res; 100K
V1: VOLTAGE; 5
Named nets: 0
.tran 25m startup
This example schematic is supplied for informational/educational purposes only.
