kaf3/dimmer/LTspice/examples/Educational/BandGaps.asc

Q1: pnp; P
Q2: pnp; P
Q3: npn; N  10
Q4: npn; N
Q5: pnp; P
Q6: pnp; P
Q7: npn; N
Q8: npn; N  10
Q9: npn; N
Q10: pnp; P
Q11: pnp; P
Q12: npn; N
Q13: npn; N  10
Q14: npn; N
Q15: pnp; P
Q16: pnp; P
Q17: npn; N
Q18: npn; N  10
Q19: npn; N
R1: res; 1210
R2: res; 10K
R3: res; 1270
R4: res; 10K
R5: res; 1250
R6: res; 5K
R7: res; 1250
R8: res; 5K
V1: voltage; 3
Named nets: 0, A, B, C, D
.dc temp -55 125 .1
.model N NPN
.model P PNP
This example schematic is supplied for informational/educational purposes only.
Four Band Gap Voltage Reference Circuits
