kaf3/dimmer/LTspice/examples/Educational/butter.asc

C1: CAP; .3396
C2: CAP; 1.125
C3: CAP; 1.099
C4: CAP; 1.125
C5: CAP; .3396
C6: CAP; .3903
C7: CAP; .9785
C8: CAP; 1.263
C9: CAP; .9785
C10: CAP; .3903
C11: CAP; .4714
C12: CAP; .8103
C13: CAP; 1.526
C14: CAP; .8103
C15: CAP; .4714
C16: CAP; .6177
C17: CAP; .6177
C18: CAP; 2
C19: CAP; .6177
C20: CAP; .6177
I1: CURRENT; AC 1.
I2: CURRENT; AC 1.
I3: CURRENT; AC 1.
I4: CURRENT; AC 1.
L1: IND2; 2.945
L2: IND2; .8890
L3: IND2; .9099
L4: IND2; .8890
L5: IND2; 2.945
L6: IND2; 2.562
L7: IND2; 1.022
L8: IND2; .7918
L9: IND2; 1.022
L10: IND2; 2.562
L11: IND2; 2.1213
L12: IND2; 1.234
L13: IND2; .6553
L14: IND2; 1.234
L15: IND2; 2.1213
L16: IND2; 1.617
L17: IND2; 1.617
L18: IND2; .5
L19: IND2; 1.617
L20: IND2; 1.617
R1: RES; 1
R2: RES; 1
R3: RES; 1
R4: RES; 1
R5: RES; 1
R6: RES; 1
R7: RES; 1
R8: RES; 1
Named nets: OUT4, OUT3, OUT2, OUT1, 0
.ac oct 50 .01 3
This example schematic is supplied for informational/educational purposes only.
