kaf3/dimmer/LTspice/examples/Educational/Clapp.asc

C1: cap; 750p
C2: cap; 50p
C3: cap; 750p
D2: diode; 1N4148
J1: NJF; 2N5484
L1: ind; 100µ
L4: ind; 1m; Rser=100
V1: VOLTAGE; 10.
Named nets: 0, OUT
.tran 250µ startup
This example schematic is supplied for informational/educational purposes only.
