kaf3/dimmer/LTspice/examples/Educational/Cohn.asc

C1: cap; {C1}
C2: cap; {C2}
C3: cap; {C1}
C4: cap; {C2}
C5: cap; {C3}
L1: ind; {L}
L2: ind; {Lm}
L3: ind; {2*L}
L4: ind; {2*L}
L5: ind; {L}
L6: ind; {Lm}
R1: RES; {R}
R2: res; {R}
V1: VOLTAGE; AC 2
Named nets: 0, OUT, IN
.ac oct 1000 10Meg 22Meg
.param x=.54 ; trimer postion
.param R=50
.param L=2.95u Lm=.27u C1=22p+x*25p C2=240p C3=34p
This example schematic is supplied for informational/educational purposes only.
