kaf3/dimmer/LTspice/examples/Educational/colpits.asc

C1: cap; 500p
C2: cap; 500p
C3: cap; 200p
D1: diode; 1N4148
L1: ind; 100µ
Q1: NJF; 2N5484
R1: RES; 500
R2: res; 1K
V1: VOLTAGE; 7.
Named nets: 0
.tran 500µ startup
.options method=trap
This example schematic is supplied for informational/educational purposes only.
