kaf3/dimmer/LTspice/examples/Educational/curvetrace.asc

I1: current; 0.
Q1: npn; 2N2222
V1: voltage; 0.
Named nets: 0
.dc V1 0 15 10m I1 20u 100u 20u
This example schematic is supplied for informational/educational purposes only.
