kaf3/dimmer/LTspice/examples/Educational/DCopPnt.asc

C1: cap; 10p
C2: cap; 100p
C3: cap; .001µ
Q1: npn; 2N3904
Q2: npn; 2N3904
Q3: pnp; 2N3906
Q4: npn; 2N3904
Q5: NPN; 2N3904
Q6: PNP; 2N3906
Q7: npn; 2N2219A
Q8: npn; 2N2219A
R1: res; 5K
R2: res; 200
R3: res; 1K
R4: res; 9K
R5: res; 1K
R6: res; 5K
R7: res; 50K
R8: res; 100
R9: res; 2K
R10: res; 1K
R11: RES; 5K
R12: res; 1K
R13: res; 1K
R14: res; 8
V1: VOLTAGE; 10
V2: voltage; -10
Named nets: 0, OUT
This example schematic is supplied for informational/educational purposes only.
.op
After the solution is found and displayed in a dialog, you can read node voltages
and device currents from the status bar by moving the mouse near the wire or part
