kaf3/dimmer/LTspice/examples/Educational/Electrometer.asc

A1: dflop; Vhigh=0 Vlow=-5; Trise=10n
C1: cap; .015p
C2: cap; 4n
C3: cap; 1000p; IC=0
C4: cap; .01µ
C5: cap; .01µ
C6: cap; .01µ
C7: cap; 2n
C8: cap; .1µ
C9: cap; 2.5p
C10: cap; 75p
C11: cap; 100p
C12: cap; .05µ; IC=0
C13: cap; .1µ; IC=0
C14: cap; .04p
C15: cap; 25p; IC=0
C16: cap; 100p
C17: cap; .2p
C18: cap; .4p
C19: cap; 50p
C20: cap; 1n
C21: cap; .01µ
C22: cap; 1n
C23: cap; 500p
C24: cap; 250p
D1: diode; 1N4148
D2: diode; 1N4148
I1: current; PULSE(0 1000p 1m 1u 1u 5m 10m)
J1: njf; 2N5432
J2: njf; 2N5432
J3: njf; 2N5432
J4: njf; 2N5432
Q1: njf; 2N4416
Q2: njf; 2N4416
Q3: njf; 2N4416
Q4: njf; 2N4416
Q5: njf; 2N4416
Q6: npn; 2N3904
Q7: npn; 2N3904
Q8: pnp; 2N3906
Q9: npn; 2N3904
Q10: pnp; 2N3906
R1: res; 500
R2: res; 25K
R3: res; 100G
R4: res; 4.99K
R5: res; 1K
R6: res; 4.75K
R7: res; 2.5K
R8: res; 1.98K
R9: res; 4.22K
R10: res; 1.2K
R11: res; 49.9
R12: res; 49.9
R13: res; 10Meg
R14: res; 1Meg
R15: res; 100K
R16: res; 10G
R17: res; 1G
R18: res; 100Meg
R19: res; 10K
R20: res; 100
R21: res; 500
R22: res; 100
R23: res; 200
R24: res; 400
T1a: ind2; 100µ
T1b: ind2; 100µ
T1c: ind2; 100µ
T2a: ind2; 50µ
T2b: ind2; 50µ
T2c: ind2; 50µ
T3a: ind2; 25µ
T3b: ind2; 25µ
T3c: ind2; 25µ
U1: LT1001
V1: voltage; 15
V2: voltage; -15
V3: voltage; pulse(-5 0 0 10n 10n .5u 1u)
Named nets: 0, +V, -V, OUT, IN
.tran 15m
K3 T3a T3b T3c 1.
K1 T1a T1b T1c 1.
K2 T2a T2b T2c 1.
Old Fashioned Electrometer Using Parametric up Conversion
These days you should just use a AD549
±1nA full scale
±1µA full scale
±100µA full scale
Add for ±1µA full scale
±10µA full scale
Add for ±100µA, ±1mA full scale
±100pA full scale
±100pA, ±1nA, ±10nA, ±100nA full scale
±10nA full scale
±100nA full scale
Add for ±10µA full scale
±1mA full scale
A 1% mismatch in J1, J2, J3, J4 capacitiances give a 6mV input offset and a 425mV output offset(4.25pA readout error) at ±100pA full scale range.
Q1, Q2, Q3, Q4 require a low drive impedance lest the gain of the loop inverts at high input currents.
±10V full scale
Trim to reduce
error to a
fraction of 1pA
