kaf3/dimmer/LTspice/examples/Educational/Fc.asc

B1: bi2; I={Cjo}/(1+max(V(bias),-.5*{Vj})/{Vj})**{m}
B2: bi2; I=max(0.,({Cjo}/(1-{Fc})**{1+m})*({1-Fc*(1+m)}-{m/Vj}*V(bias)))
B3: bi2; I=V(cap)
D1: diode; DX
R9: res; 100
U1: capmeter; current=1m freq=3Meg C=.25µ
V1: voltage; pwl(0 -10 1m 10)
Named nets: 0, bias, cap, res
.tran 1m
.options maxstep=.0125u
.params Cjo=930p m=.75 Vj=1.2 Fc=0.;-.5
.include capometer.sub
.model DX D(Is=0 Cjo={Cjo} m={m} vj={Vj} Fc={Fc} tt=.5u))
*.model DX D(Is=0 Cjo={Cjo} m={m} vj={Vj} Fc={Fc} tt=.5u)
This example schematic is supplied for informational/educational purposes only.
