kaf3/dimmer/LTspice/examples/Educational/GFT.asc

B1: bi; I=I(V1)
B2: bi; I=I(V2)
B3: bi; I=I(V3)
B4: bi; I=I(V4)
C1d: cap; 30p
C2d: cap; 16p
C3d: cap; 30p
C3t: cap; 5p
C4d: cap; 160p
C4t: cap; 50p
Cc: cap; 5p
Ct1: cap; 5p
Ct2: cap; 5p
Ey: e; 1
Iz: current; ""; AC {0.5*z*(z+1)}
R1: res; 100
R2: res; 900
R3: res; 200
R8: res; 10Meg
RL: res; 1k
Rm1: res; 50
Rm2: res; 200
Rm3: res; 50
Rm4: res; 10
Rs: res; 100
V1: voltage; 0
V2: voltage; 0
V3: voltage; 0
V4: voltage; 0
Vi: voltage; ""; AC {1-z*z}
Viy: voltage; 0
Vz: voltage; ""; AC {0.5*z*(z-1)}
Named nets: 0, Y, O
.ac dec 100 100m 100G
.param z=0
.step param z list -1 0 1
This example schematic is supplied for informational/educational purposes only.
We thank Frank Wiedmann for contributing this example.
This example shows how to simulate the quantities of the General Feedback Theorem, which are defined in the article
 R. David Middlebrook, "The General Feedback Theorem: A Final Solution for Feedback Systems", IEEE Microwave Magazine, vol. 7, no. 2, pp. 50-63, April 2006.
This article can be downloaded from http://resolver.caltech.edu/CaltechAUTHORS:MIDieeemm06 .
See also message 18008 of the independent LTspice users' group at http://groups.yahoo.com/group/LTspice where this method was originally presented by Frank Wiedmann.
* For this example, add the following definitions to the plot.defs file:
* A() is an auxiliary quantity.
* Dd() corresponds to D.
* Hinf() corresponds to H_infinity.
* All other function names are equal to those of the corresponding quantities.
 
.func A()    =  V(o)@2*(V(y)@1*I(Viy)@3-V(y)@3*I(Viy)@1)+V(o)@1
+ *(V(y)@3*I(Viy)@2-V(y)@2*I(Viy)@3)+V(o)@3
+ *(V(y)@2*I(Viy)@1-V(y)@1*I(Viy)@2)
.func Dd()   =  V(y)@1*I(Viy)@3-V(y)@3*I(Viy)@1
.func H()    =  V(o)@2
.func Hinf() =  A()/Dd()
.func T()    = 1/(1/Dd()-1)
.func Dn()   = H()/A()
.func Tn()   = 1/(Dn()-1)
.func D0()   = 1-Dd()
.func H0()   = (H()-A())/D0()
