kaf3/dimmer/LTspice/examples/Educational/HalfSlope.asc

G2: g; Laplace=1/sqrt(1+1u*s)/(1+5n*s)**2
R1: res; 1.
V1: voltage; PULSE(0 1 0 1n 1n 5u 10u) AC 1
Named nets: 0, B
*.ac oct 20 1K 10Meg
.tran 30u
Time domain response of a 3db/octive rolloff
This example schematic is supplied for informational/educational purposes only.
