kaf3/dimmer/LTspice/examples/Educational/Hartly.asc

C1: cap; 500p
C2: cap; 30p
C4: cap; 250p
D2: diode; 1N4148
J1: njf; 2N5484
L1: ind2; 30µ
L2: ind2; 30µ
L3: ind2; 3µ
L4: ind; 1m; Rser=100
V1: voltage; 10.
Named nets: 0, out
.tran 250µ startup
K1 L1 L2 L3 1.
This example schematic is supplied for informational/educational purposes only.
