kaf3/dimmer/LTspice/examples/Educational/Howland.asc

R1: res; 1K
R2: res; 1K
R3: res; 1K
R4: res; 1K
Rload: res; {x}
U2: LT1001
V1: voltage; +15
V2: voltage; -15
V3: voltage; SINE(0 1 1K)
Named nets: 0, +V, -V, IN
.tran 3m
.step param X list 1 10 100 1K
Iout = V(in)/1K
This example schematic is supplied for informational/educational purposes only.
