kaf3/dimmer/LTspice/examples/Educational/IdealTransformer.asc

G1: g; 1
G2: g; {1/N}
G3: g; 1
G4: g; {1/N}
R1: res; 1
R2: res; 1G
R3: res; 100
V1: voltage; PULSE(0 1 0 10n 10n 5u 10u)
Named nets: 0
.tran 100u
This example schematic is supplied for informational/educational purposes only.
A ideal transformer with two windings.
Winding ratio specified with parameter N
.param N=10 ; turns ratio
