kaf3/dimmer/LTspice/examples/Educational/IGBT.asc

V1: voltage; 0
V2: voltage; 0
Z1: nigbt
Named nets: 0
.model NIGBT NIGBT
.dc V1 0 25 1m V2 0 20 5
