kaf3/dimmer/LTspice/examples/Educational/ISO16750-2_example.asc

U1: ISO16750-2
U2: ISO16750-2
Named nets: 0
.tran 0 20 0 1m
For documentation see:
  LTspice Models of ISO 7637-2 & ISO 16750-2 Transients
  http://www.linear.com/solutions/7719
ISO 16750-2 Transients
