kaf3/dimmer/LTspice/examples/Educational/Linkwitz.asc

C1: cap; {Cspk}; Rser={Rspk}
C2: cap; {C2}
C3: cap; {C2}
C4: cap; {C1}
C5: cap; {C3}
E1: e; 1
L1: ind; {Lspk}; Rser=0
R1: res; {R1}
R2: res; {R1}
R3: res; {R2}
R4: res; {R2}
R5: res; {R3}
R6: res; {R3}
U1: UniversalOpamp2
V1: voltage; ac 1
V2: voltage; {R1/1K}
V3: voltage; {R2/1K}
V4: voltage; {R3/1K}
V5: voltage; {C1/1u}
V6: voltage; {C3/1u}
V7: voltage; {Vb}
Named nets: 0, OUT, EQ, IN
.param Vb  = Vas / ((Qtc/Qts) * (Qtc/Qts) - 1.)
.param Fc   = Fs * sqrt(( Vas/Vb) + 1.) 
.param Lspk  = 1
.param Cspk  = 1. / (39.47842 * Fc * Fc * Lspk)
.param Rspk  = 6.2831853 * Fc / Qtc
.param Fs =95
.param Qts=0.472
.param Vas=0.04481
.ac oct 10 10 10K
.param k   = (Fc0/Fcx-Qt0/Qtx)/(Qt0/Qtx-Fcx/Fc0)
.param R1  = (1/(2*pi*Fc0*C2*(2*Qt0*(1+k))))
.param R2  = 2*k*R1
.param R3  = R1*(Fc0/Fcx)**2
.param C1  = C2*(2*Qt0*(1+k))**2
.param C3  = C1*(Fcx/Fc0)**2
;.param gain=40*Log10(Fc0/Fcx) ; FYI
Linkwitz-Riley Transform: equalize a driver in a sealed box to a different Q and cutoff frequency
Driver Characteristics
Sealed Box
Plot V(eq) to see Linkwitz transfer function
Plot V(out)/V(eq) to see speaker transfer function
Plot V(out) for net transfer function
Voltage to Sound Pressure Level Equiv. Circuit
This example schematic is supplied for informational/educational purposes only.
This is the theory of the PA system used in the 2015 World Circuit Seminar
Tour except (i) the electronics I traveled with include baffle step
compensation (ii) the microphone aperture was adjusted to add
4dB @ 16kHz to enhance sibilance and (iii) the drivers were a vertical array.
These voltage sources read
out the component values to
implement the equalizer
Sealed box
volume in same
units as Vas
Input Parameters
.param Qtc = 0.7071
Input parameter
Input parameters appropriate
for the Fountek FR88EX
 3" Full Range Al cone
.param C2=.047u
.param Fc0 = Fc      ; Fc untransformed
.param Qt0 = Qtc     ; Qtc untransformed
.param Fcx = 80       ; Fc transformed(chosen on spectral analysis of my voice)
.param Qtx = 0.7071 ; Qtc transformed
