kaf3/dimmer/LTspice/examples/Educational/LM308.asc

C1: cap; 10p
J1: NJF; NJ
Q1: npn; NP
Q2: npn; NP
Q3: NPN3; SB
Q4: npn3; SB
Q5: npn3; SB
Q6: npn3; SB
Q7: npn3; SB
Q8: pnp; PN
Q9: pnp; PN
Q10: pnp; PN
Q11: pnp; PN
Q12: npn3; SB
Q13: npn3; SB
Q14: pnp; PN
Q15: npn; NP
Q16: npn; NP
Q17: pnp; PN
Q18: npn3; SB
Q19: npn; NP
Q20: pnp; PN
Q21: pnp; PN
Q22: npn3; SB
Q23: npn; NP
Q24: npn3; SB
Q25: pnp; PN
Q26: npn3; SB
Q27: npn3; SB
Q28: pnp; PN
Q29: npn3; SB
R1: res; 2K
R2: res; 10K
R3: res; 20K
R4: res; 10K
R5: res; 20K
R6: res; 6.4K
R7: res; 2K
R8: res; 50K
R9: res; 60K
R10: res; 5.6K
R11: res; 940
R12: res; 500
R13: res; 20K
R14: res; 1K
R15: res; 20K
R16: res; 2K
R17: res; 240
R18: res; 90
R19: res; 820
R20: res; 10K
R21: res; 1K
R22: res; 1K
V1: voltage; +15
V2: voltage; -15
V3: voltage; SINE(0 1.2 1K)
Named nets: 2, 3, 1, 8, 6, 7, 4, 0
IN-
IN+
.tran 10m startup
.model NJ NJF
.model NP NPN(BF=125 Cje=.5p Cjc=.5p Rb=500)
.model PN LPNP(BF=25 Cje=.3p Cjc=1.5p Rb=250)
.model SB NPN(BF=5000 Cje=1p Cjc=1p Rb=500)
This example schematic is supplied for informational/educational purposes only.
OUT
V+
V-
