kaf3/dimmer/LTspice/examples/Educational/LM741.asc

C1: cap; 30p
Q1: NPN; NP
Q2: npn; NP
Q3: npn; NP
Q4: pnp; PN
Q5: PNP; PN
Q6: pnp; PN
Q7: npn; NP
Q8: npn; NP
Q9: pnp; PN
Q10: pnp; PN
Q11: pnp; PN
Q12: npn; NP
Q13: npn; NP
Q14: npn; NP
Q15: npn; NP
Q16: npn; NP
Q17: npn; NP
Q18: npn; NP
Q19: pnp; PN
Q20: npn; NP
R1: RES; 1K
R2: res; 50K
R3: res; 1K
R4: res; 5K
R5: res; 50K
R6: res; 50
R7: res; 7.5K
R8: res; 4.5K
R9: res; 25
R10: res; 50
R11: res; 10K
R12: res; 1K
R13: res; 39K
R14: res; 10K
V1: VOLTAGE; -15
V2: voltage; 15
V3: voltage; SINE(0 1 1K)
Named nets: 3, 2, 0, 6, 7, 4
IN+
IN-
OUT
.tran 10m
This example schematic is supplied for informational/educational purposes only.
V-
V+
.model NP NPN(BF=125 Cje=.5p Cjc=.5p Rb=500)
.model PN LPNP(BF=25 Cje=.3p Cjc=1.5p Rb=250)
