kaf3/dimmer/LTspice/examples/Educational/logamp.asc

B1: BV; V=exp(time-7)
C1: cap; 30p
D1: diode; 1N4148
I1: CURRENT; 100µ
Q1: NPN; 2N3904
Q2: npn; 2N3904
R1: RES; 1K
R2: res; 1K
R3: res; 15K
U1: OPAMP
U2: OPAMP
Named nets: 0, OUT, IN
.tran 10
.include opamp.sub
.options maxstep=2m
Log amp
This example schematic is supplied for informational/educational purposes only.
