kaf3/dimmer/LTspice/examples/Educational/LoopGain.asc

C1: cap; 3p
C2: cap; 3p
I1: current; 1
R1: res; 100
R2: res; 1K
R3: res; 1K
R4: res; 100
R5: res; 1K
R6: res; 1K
U1: LT1001
U2: LT1001
V1: voltage; 15
V2: voltage; 1
V3: voltage; 0
V4: voltage; 0
V5: voltage; -15
Named nets: 0, X, Y, +V, -V
.ac dec 30 .1 100Meg
Elements added to 
compute current gain
Gi=I(V3)/I(V4)
Element added to 
compute voltage gain
Gv=-V(x)/V(y)
Here the open loop gain is determined from the closed loop system[1].
The voltage gain and current gain are independently measured in
two circuits identical except for the elements inserted into
the loop to make the measurements.  Then the open loop gain
can be plotted by plotting the quantity:
 
((I(V3)/I(V4))*(-V(x)/V(y))-1)/((I(V3)/I(V4))+(-V(x)/V(y))+2)
 
Alternatively, you can add the lines
.func Gi()=I(V3)/I(V4)
.func Gv()=-V(x)/V(y)
.func middlebrook(x,y) = (x*y-1)/(x+y+2)
to your plot.defs file and then plot the quantity
middlebrook(Gi(),Gv())
This example schematic is supplied for informational/educational purposes only.
1] Middlebrook, R.D., "Measurement of Loop Gain in Feedback Systems", Int. J. Electronics, vol 38, No. 4, pp. 485-512, 1975
See the example file LoopGain2.asc for an improved technique.
