kaf3/dimmer/(list of files, drawings)

Other design files:
altium projects/Smart Dimmer/digital.SchDoc
altium projects/Smart Dimmer/dimmer.SchDoc
altium projects/Smart Dimmer/dimmer_sensor.SchDoc
altium projects/Smart Dimmer/power.SchDoc
altium projects/Smart Dimmer/Smart Dimmer.PrjPcb
altium projects/Smart Dimmer/test_lib.SchLib
