kaf3/dimmer/(commit log)

2020-10-05 tracing 5
    [Smart Dimmer.PrjPcb, dimmer.SchDoc]
2020-10-07 tracing sec
    [dimmer.SchDoc]
2020-10-08 trace digi
    [dimmer.SchDoc]
2020-10-11 trace 2
2020-10-12 trace encore
    [Smart Dimmer.PrjPcb, dimmer.SchDoc]
2020-10-20 new rules
    [Smart Dimmer.PrjPcb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]
2020-11-03 trace sensor
    [Smart Dimmer.PrjPcb, dimmer.SchDoc, dimmer_sensor.SchDoc, test_lib.SchLib]
2020-11-10 new trace
    [dimmer.SchDoc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]
2020-11-17 out phoyo
    [Smart Dimmer.PrjPcb]
2020-11-24 arduino files
    [PCB10_sensor.GBL, PCB10_sensor.GBO, PCB10_sensor.GBS, PCB10_sensor.GKO, PCB10_sensor.GTL, PCB10_sensor.GTO, PCB10_sensor.GTS, PCB12_sensor.GBL]
2020-11-25 fix bugs
    [Smart Dimmer.PrjPcb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]
2020-11-30 diplom text
    [FAN3100TSX.PcbLib, FAN3100TSX.PrjPcb, FAN3100TSX.SchLib, IC_ON_Semi_FAN3100TSX_eec.STEP, IC_ON_Semi_FAN3100TSX_eec.SchLib, IC_ON_Semi_FAN3100TSX_eec_0.PcbLib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]
2021-01-13 diplom dimmer probe
    [Smart Dimmer.PrjPcb]
2021-02-03 new api key
    [BOM для чип и дип.xlsx]
